Pyroblastouille/Bachelor/readme.md

# Conception d'un plateau de jeu magnétique automatisé
Voir [Rapport/ISC_EMB_resume_diplome_Mariot_Bechevet_2025.pdf](Rapport/ISC_EMB_resume_diplome_Mariot_Bechevet_2025.pdf)
