Pyroblastouille/Bachelor/TB_Controller/1.gif

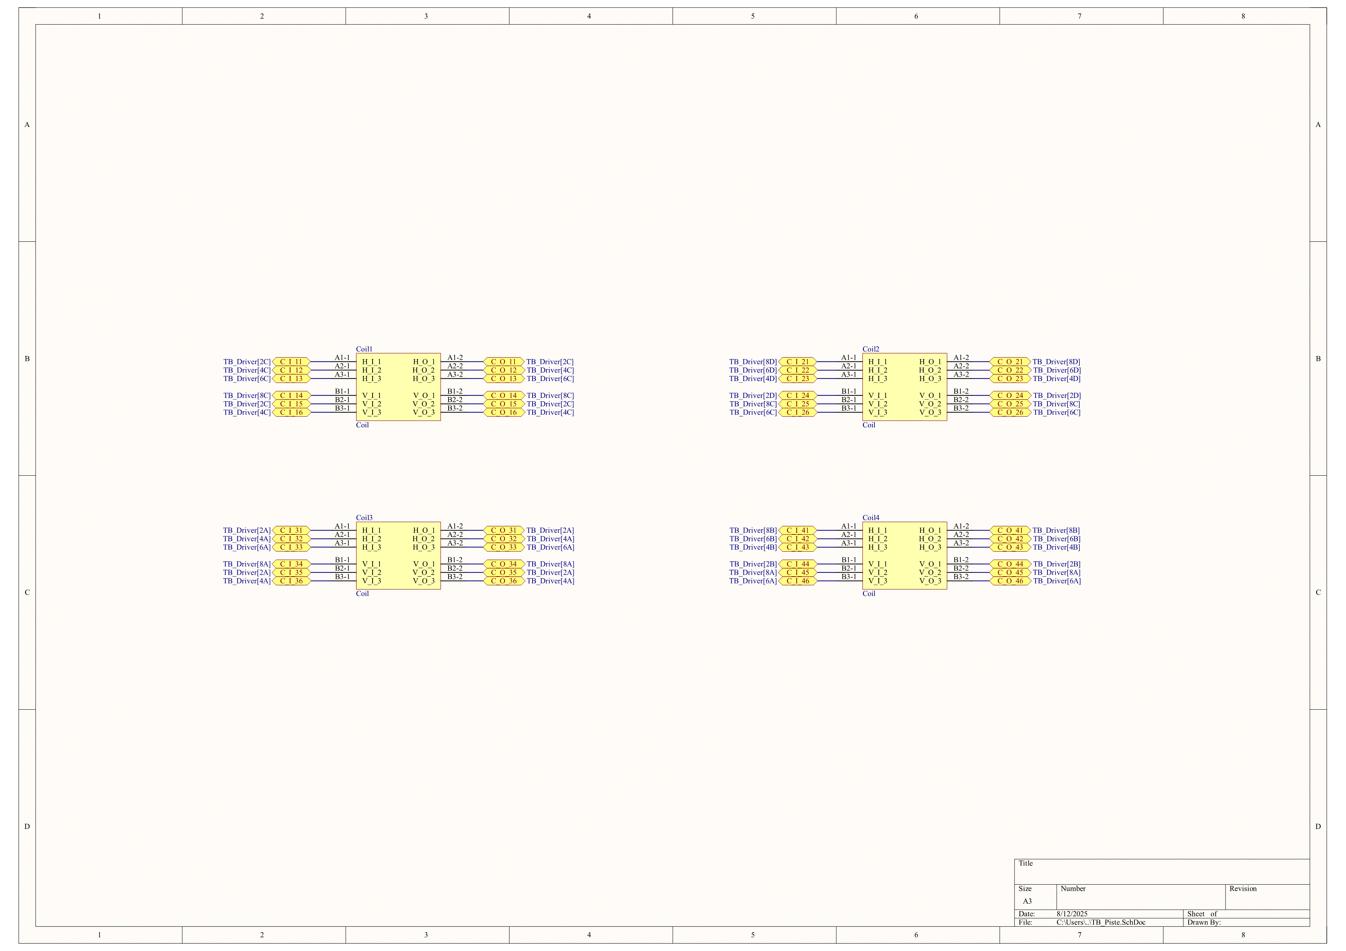
TB_Controller/1.gif
