Pyroblastouille/Bachelor/TB_Controller/2.gif

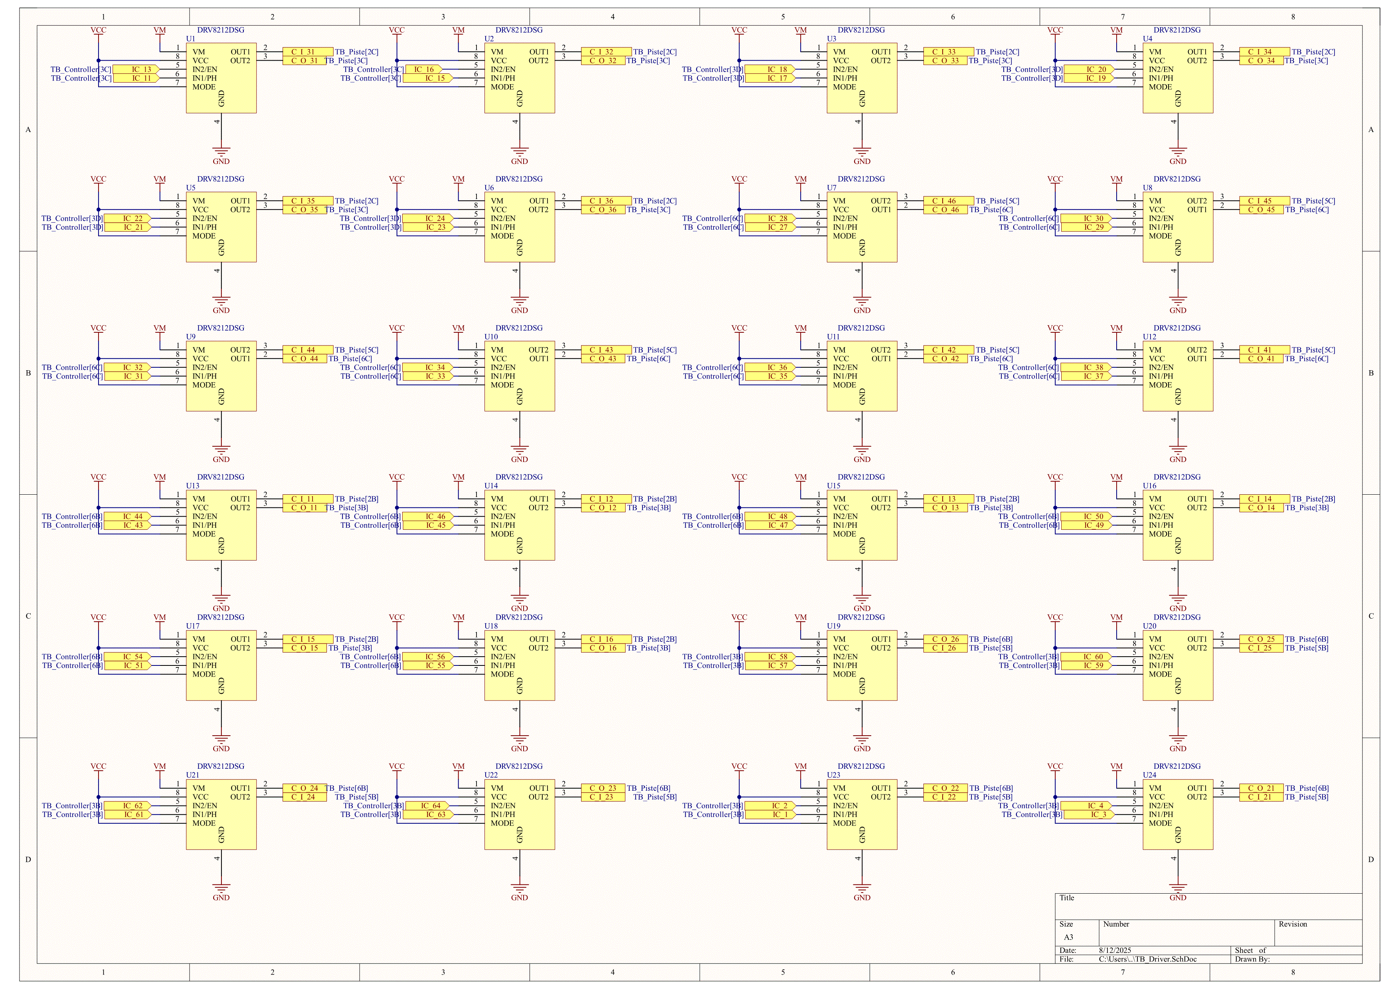
TB_Controller/2.gif
