Pyroblastouille/Bachelor/TB_Controller/3.gif

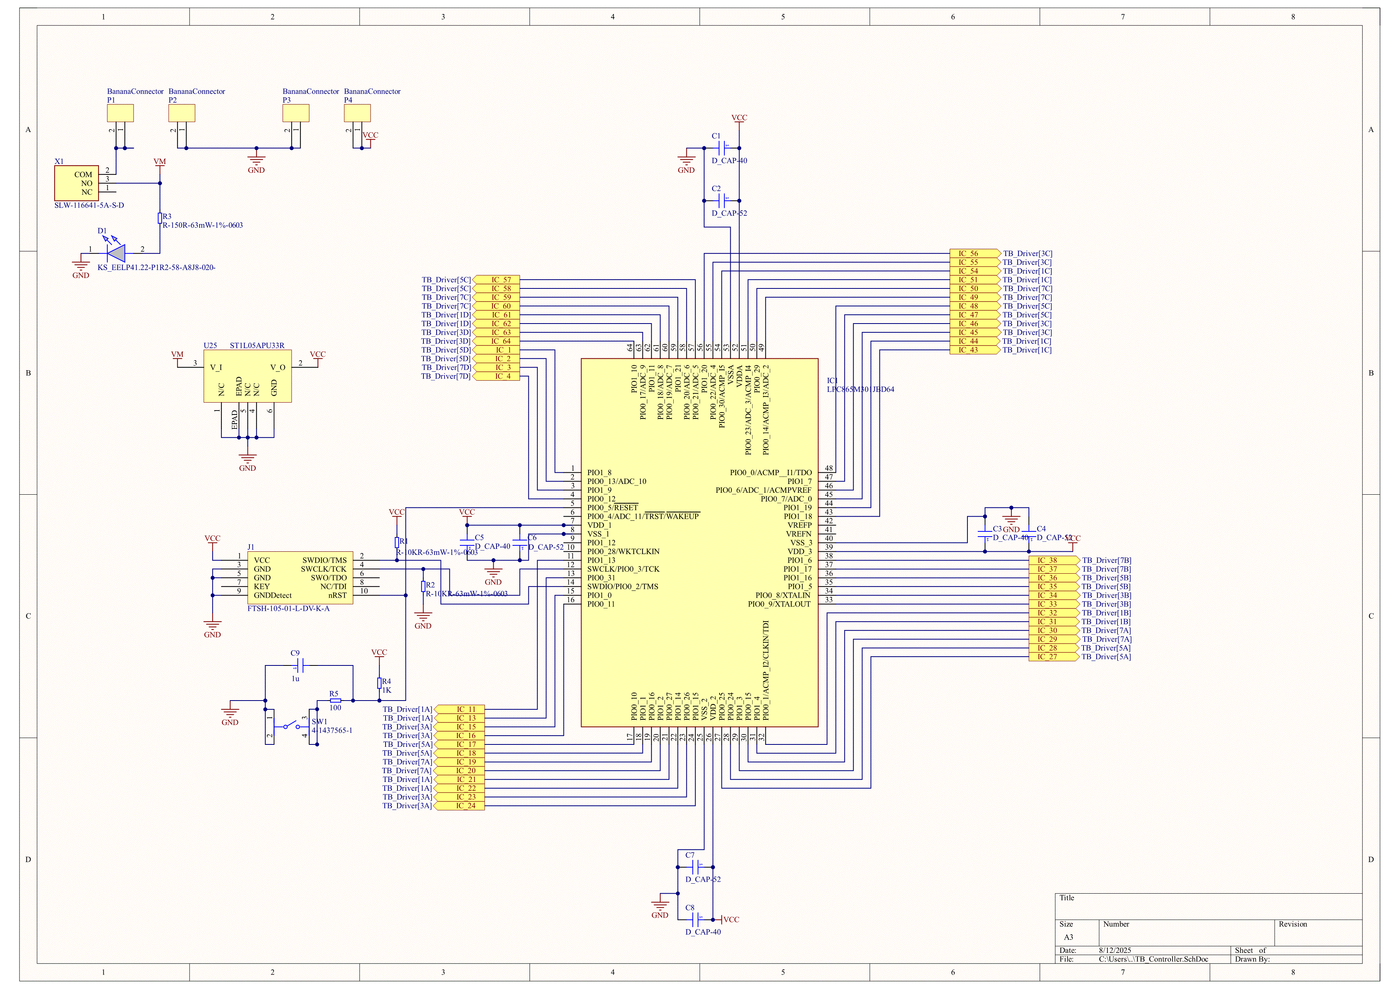
TB_Controller/3.gif
