Pyroblastouille/Bachelor/TB_Controller/4.gif

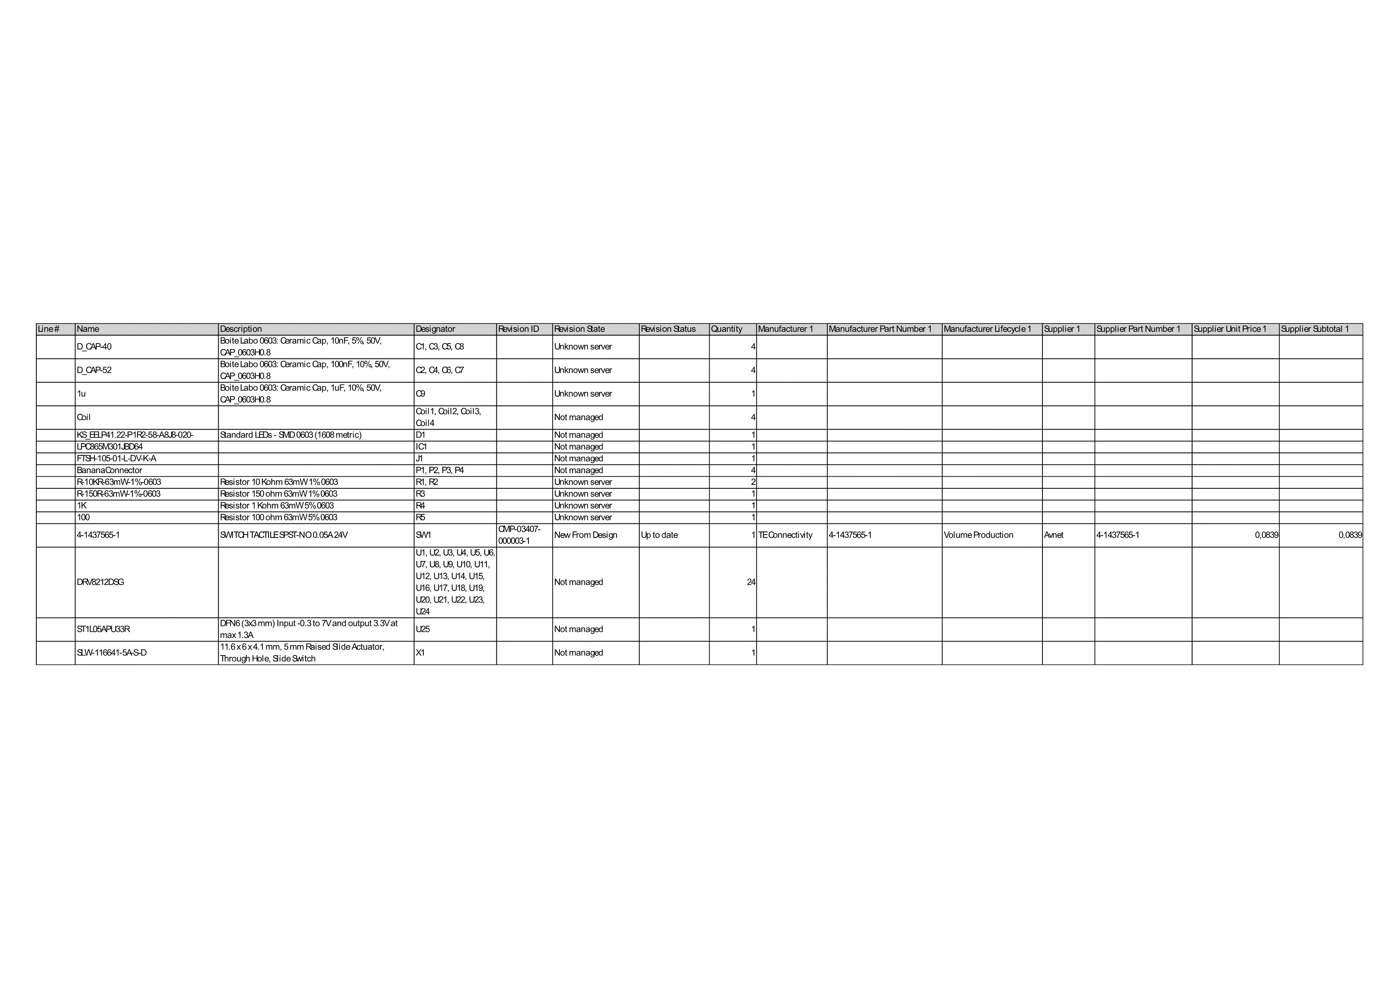
TB_Controller/4.gif
