Pyroblastouille/Bachelor/TB_Controller/TB_Controller-1.png

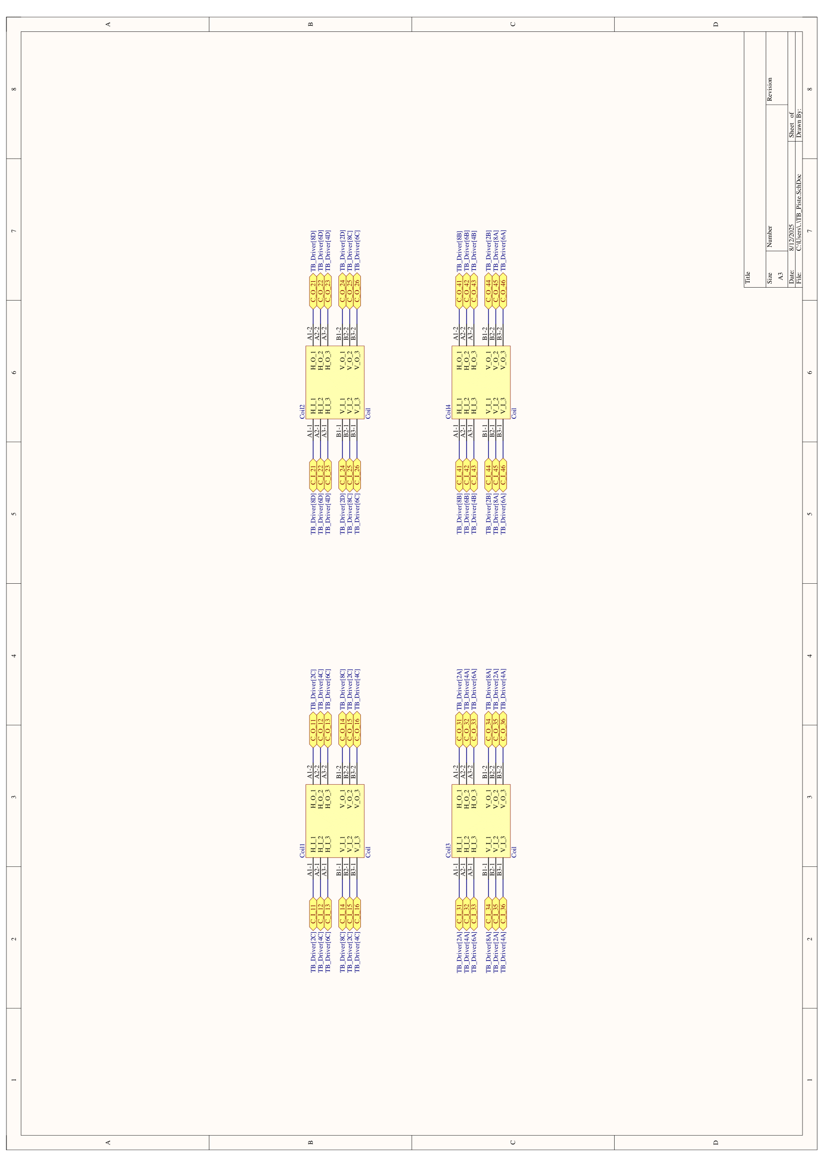
TB_Controller/TB_Controller-1.png
