Pyroblastouille/Bachelor/TB_Controller/TB_Controller-2.png

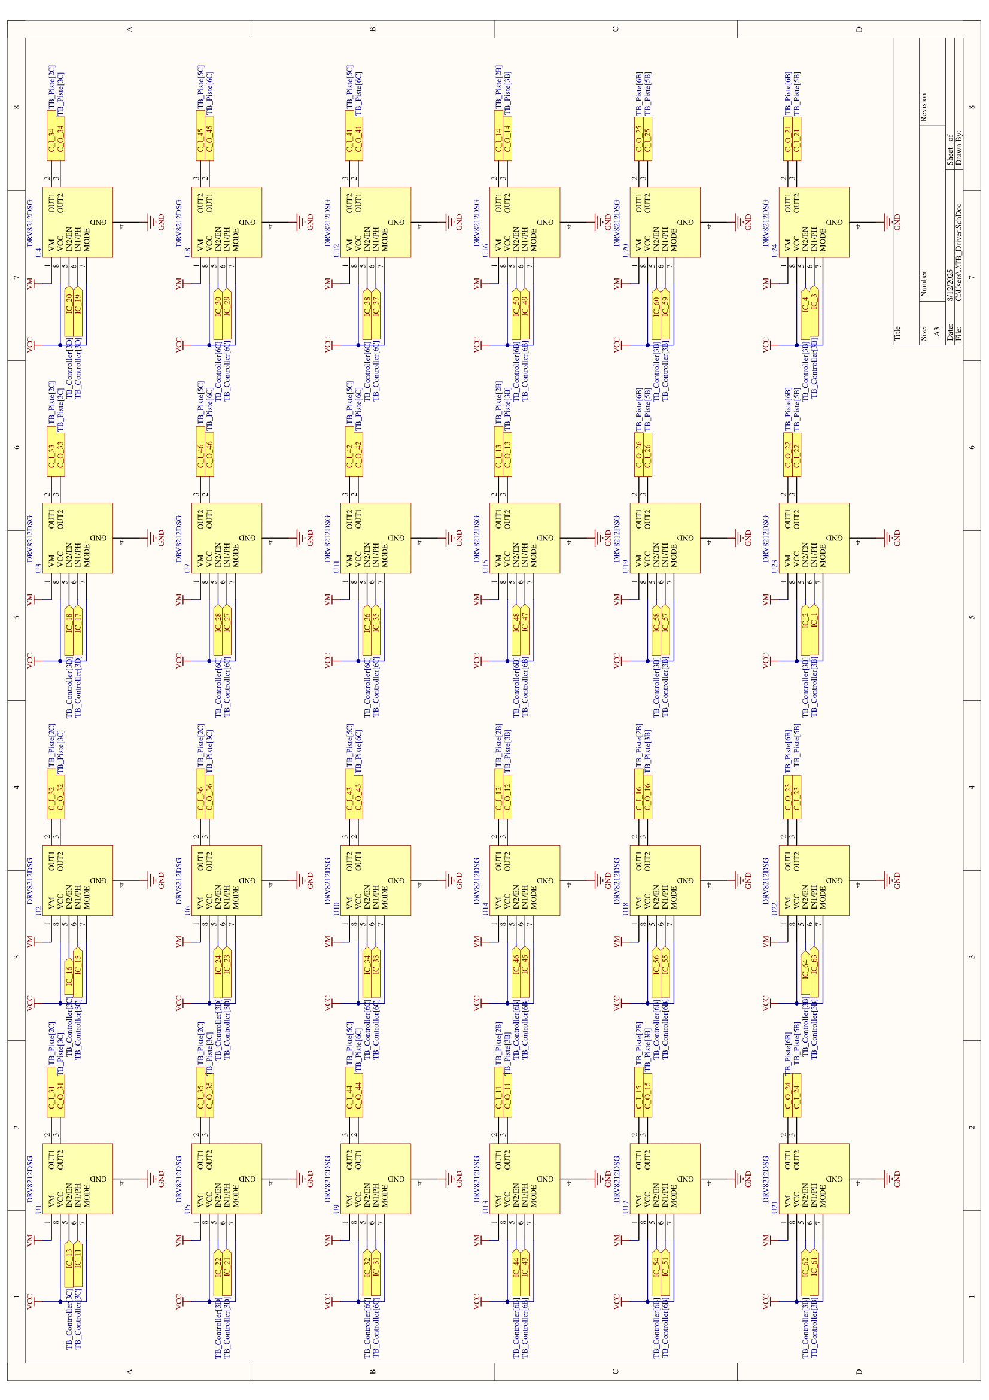
TB_Controller/TB_Controller-2.png
