Pyroblastouille/Bachelor/TB_Controller/TB_Controller-3.png

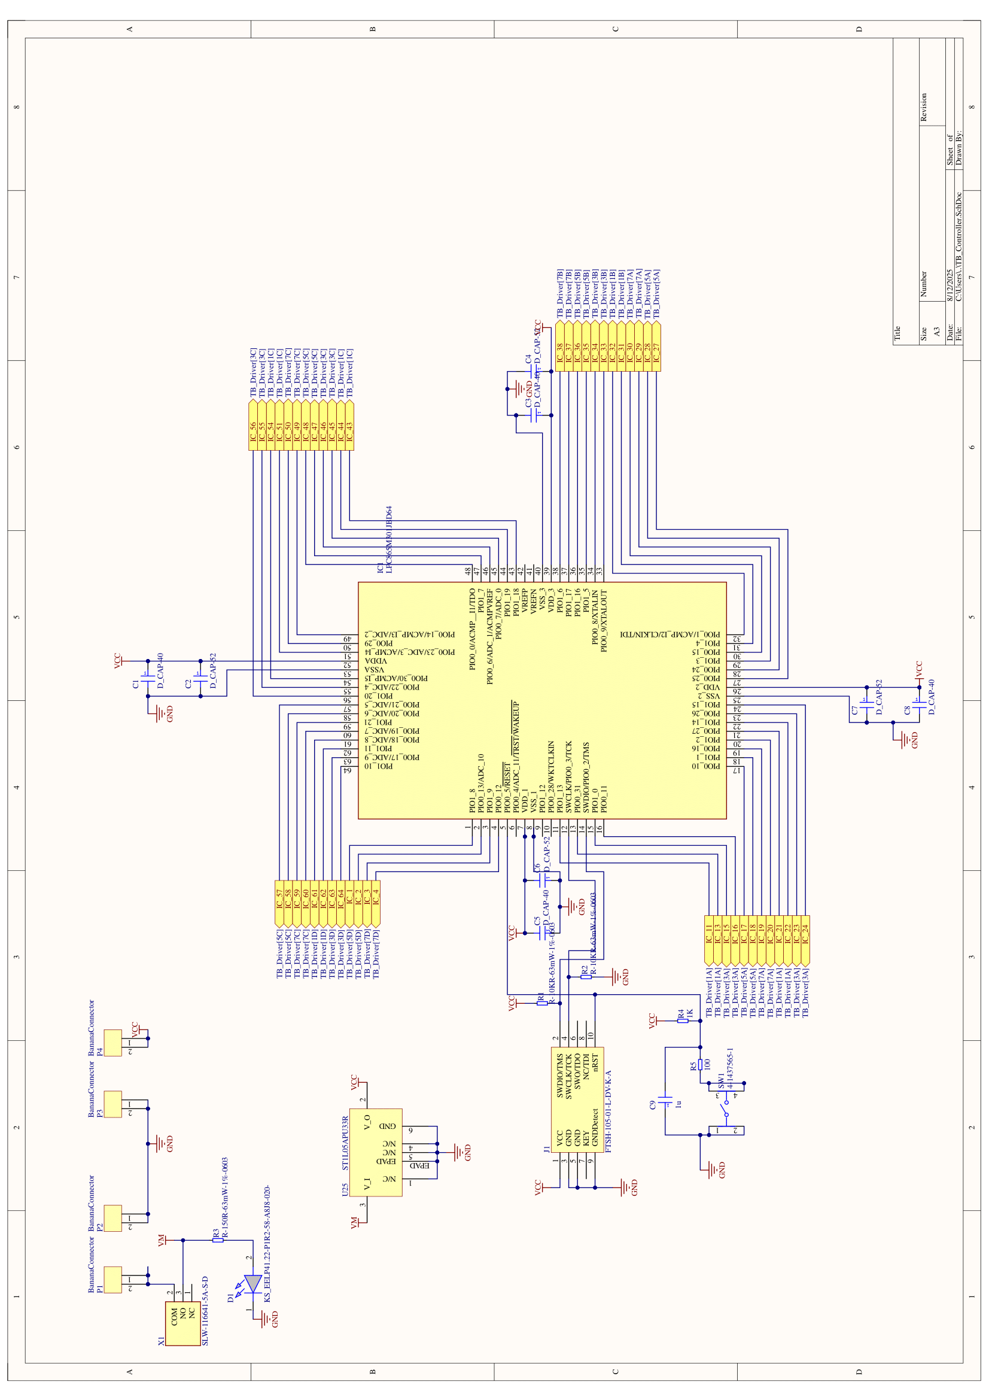
TB_Controller/TB_Controller-3.png
