Pyroblastouille/Bachelor/TB_Controller/TB_Controller-4.png

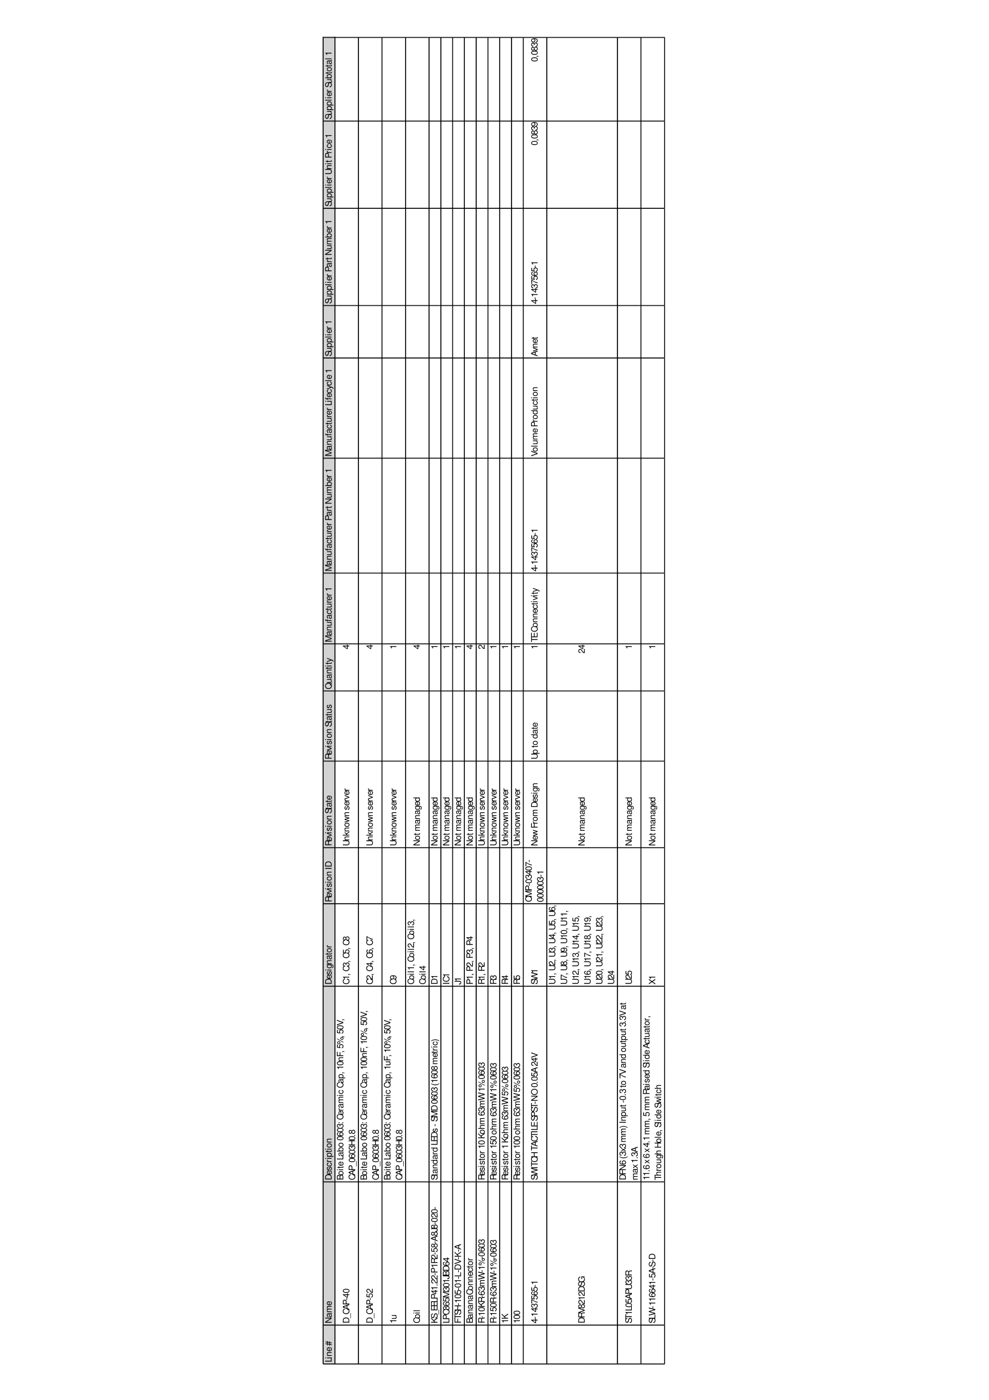
TB_Controller/TB_Controller-4.png
