Pyroblastouille/Bachelor/Prototype 1/Bill of Materials-TB_BOM.xlsx

Name | Description | Designator | Quantity
D_CAP-40 | Boite Labo 0603: Ceramic Cap, 10nF, 5%, 50V, CAP_0603H0.8 | C1, C3, C5, C8 | 4
D_CAP-52 | Boite Labo 0603: Ceramic Cap, 100nF, 10%, 50V, CAP_0603H0.8 | C2, C4, C6, C7 | 4
D_CAP-64 | Boite Labo 0603: Ceramic Cap, 1uF, 10%, 50V, CAP_0603H0.8 | C9 | 1
KS_EELP41.22-P1R2-58-A8J8-020- | Standard LEDs - SMD 0603 (1608 metric) | D1 | 1
LPC865M301JBD64 | Microcontrôleur | IC1 | 1
FTSH-105-01-L-DV-K-A | Connecteur SWD | J1 | 1
BananaConnector | Connecteur Banane | P1, P2, P3, P4 | 4
R-10KR-63mW-1%-0603 | Resistor 10 Kohm 63mW 1% 0603 | R1, R2 | 2
R-150R-63mW-1%-0603 | Resistor 150 ohm 63mW 1% 0603 | R3 | 1
R-1KR-63mW-5%-0603 | Resistor 1 Kohm 63mW 5% 0603 | R4 | 1
R-100R-63mW-5%-0603 | Resistor 100 ohm 63mW 5% 0603 | R5 | 1
4-1437565-1 | SWITCH TACTILE SPST-NO 0.05A 24V | SW1 | 1
DRV8212DSG | Pont en H | U1, U2, U3, U4, U5, U6, U7, U8, U9, U10, U11, U12, U13, U14, U15, U16, U17, U18, U19, U20, U21, U22, U23, U24 | 24
ST1L05APU33R | DFN6 (3x3 mm) Input -0.3 to 7V and output 3.3V at max 1.3A | U25 | 1
SLW-116641-5A-S-D | 11.6 x 6 x 4.1 mm, 5 mm Raised Slide Actuator, Through Hole, Slide Switch | X1 | 1
