Pyroblastouille/Bachelor/TB_Controller.pdf

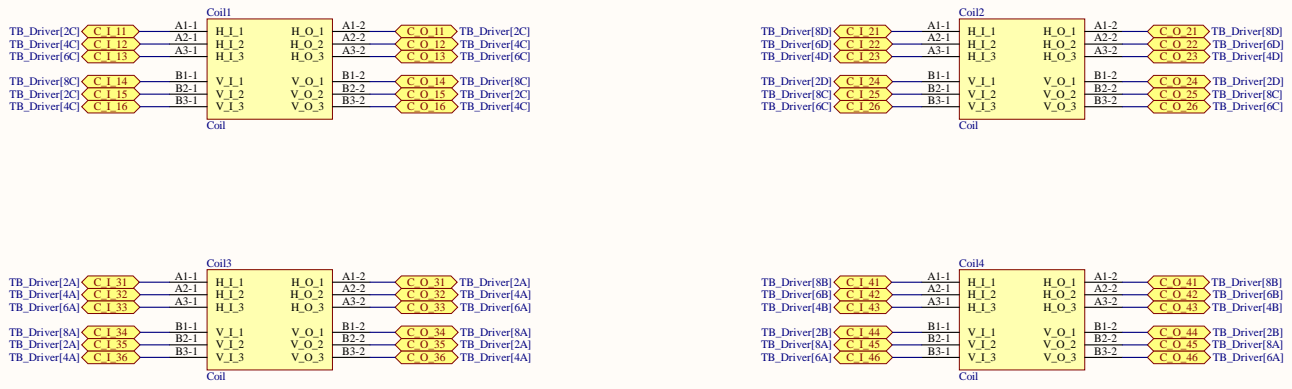
[picture p28: page 1]

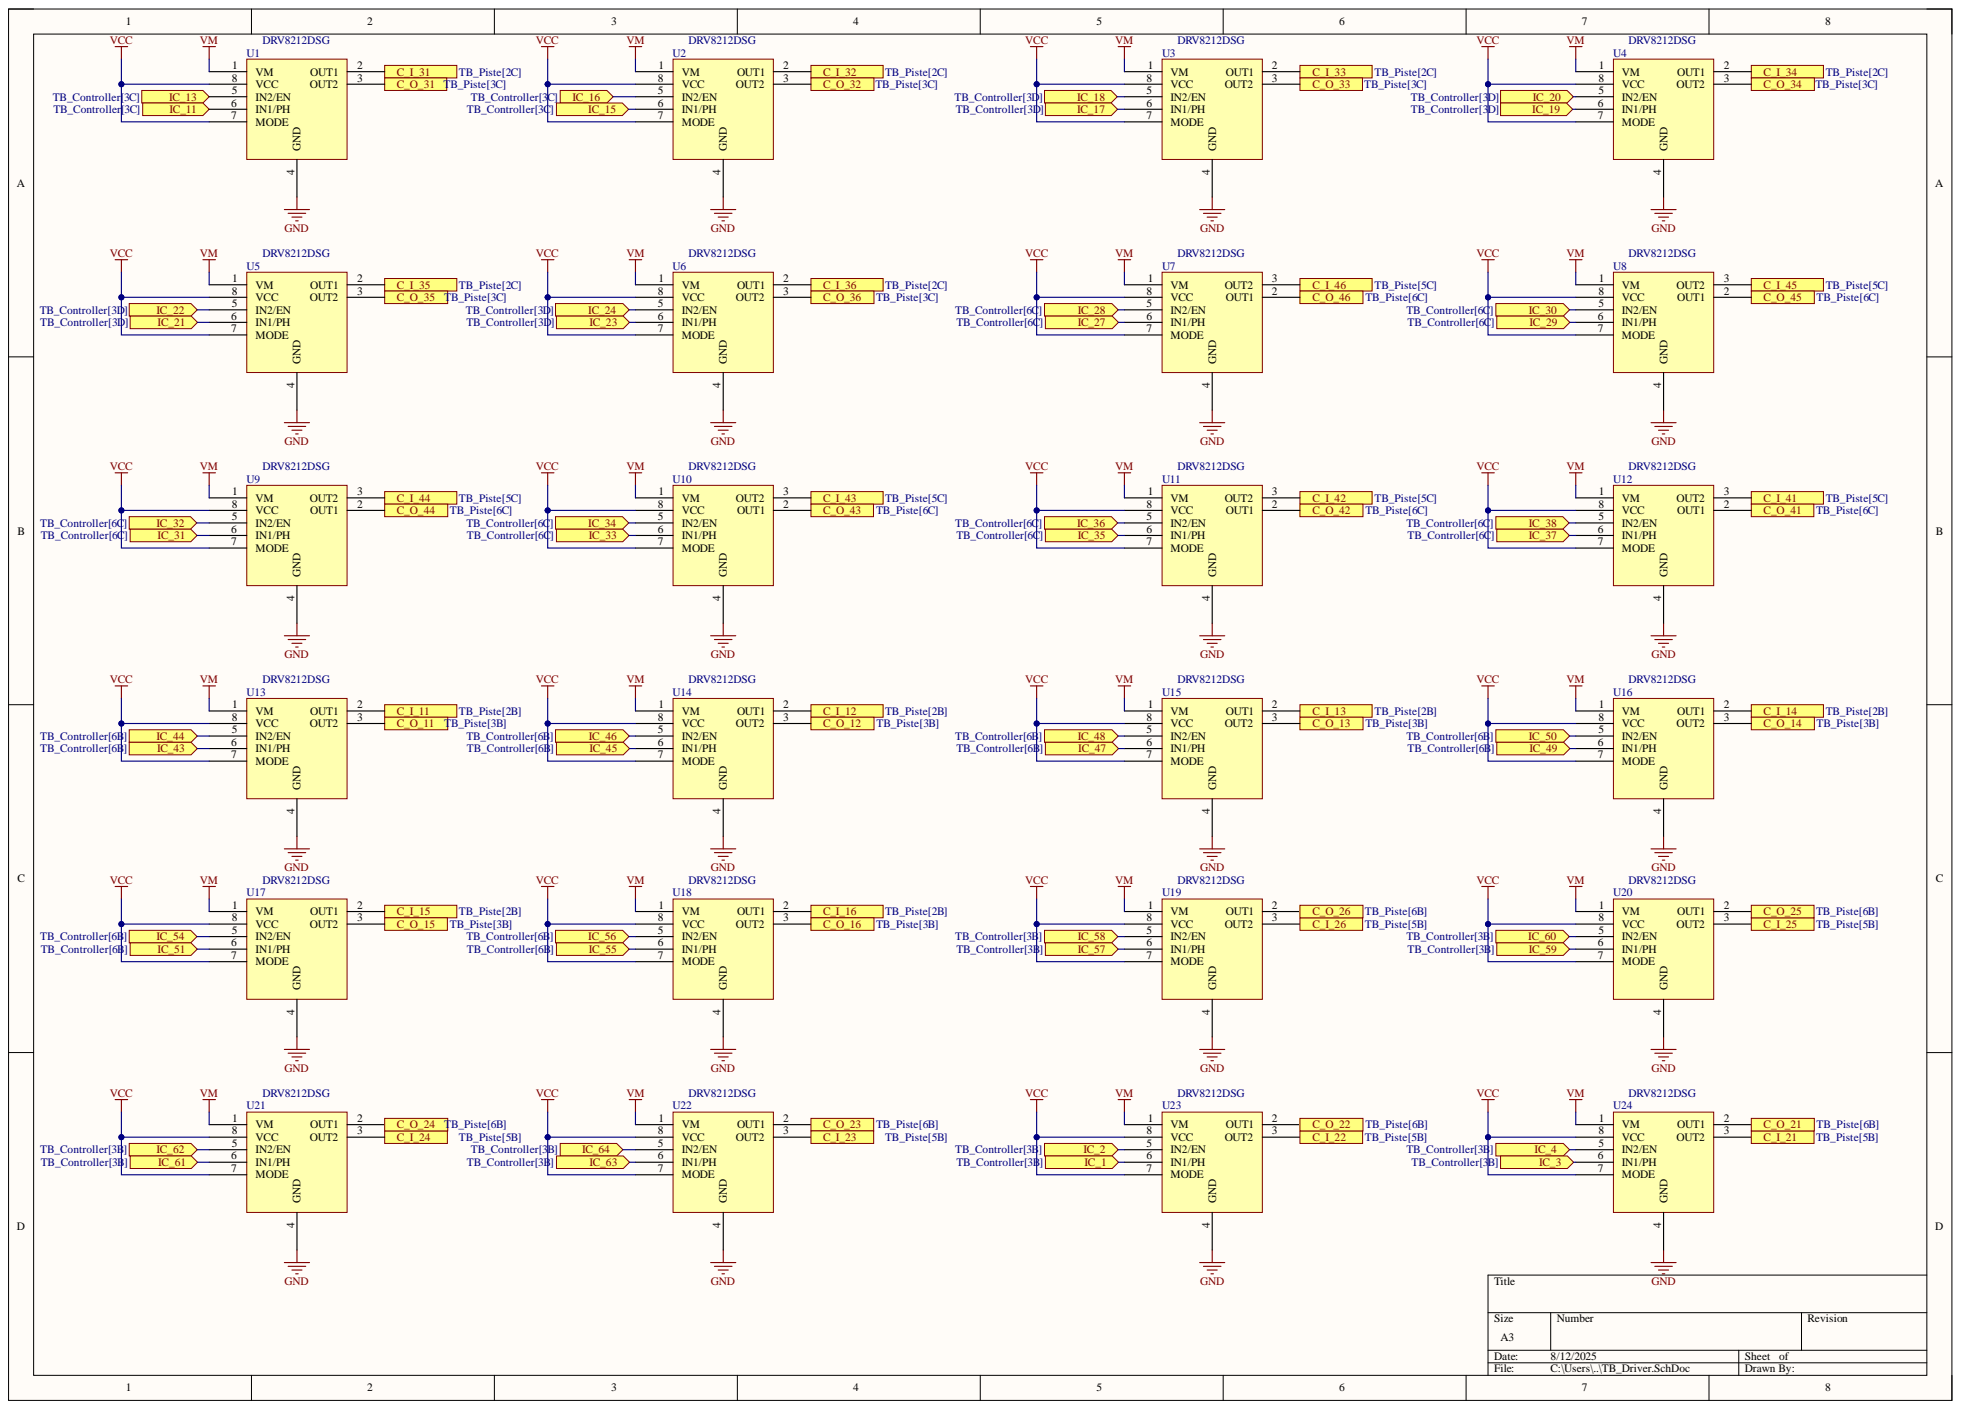
[picture p29: page 2]

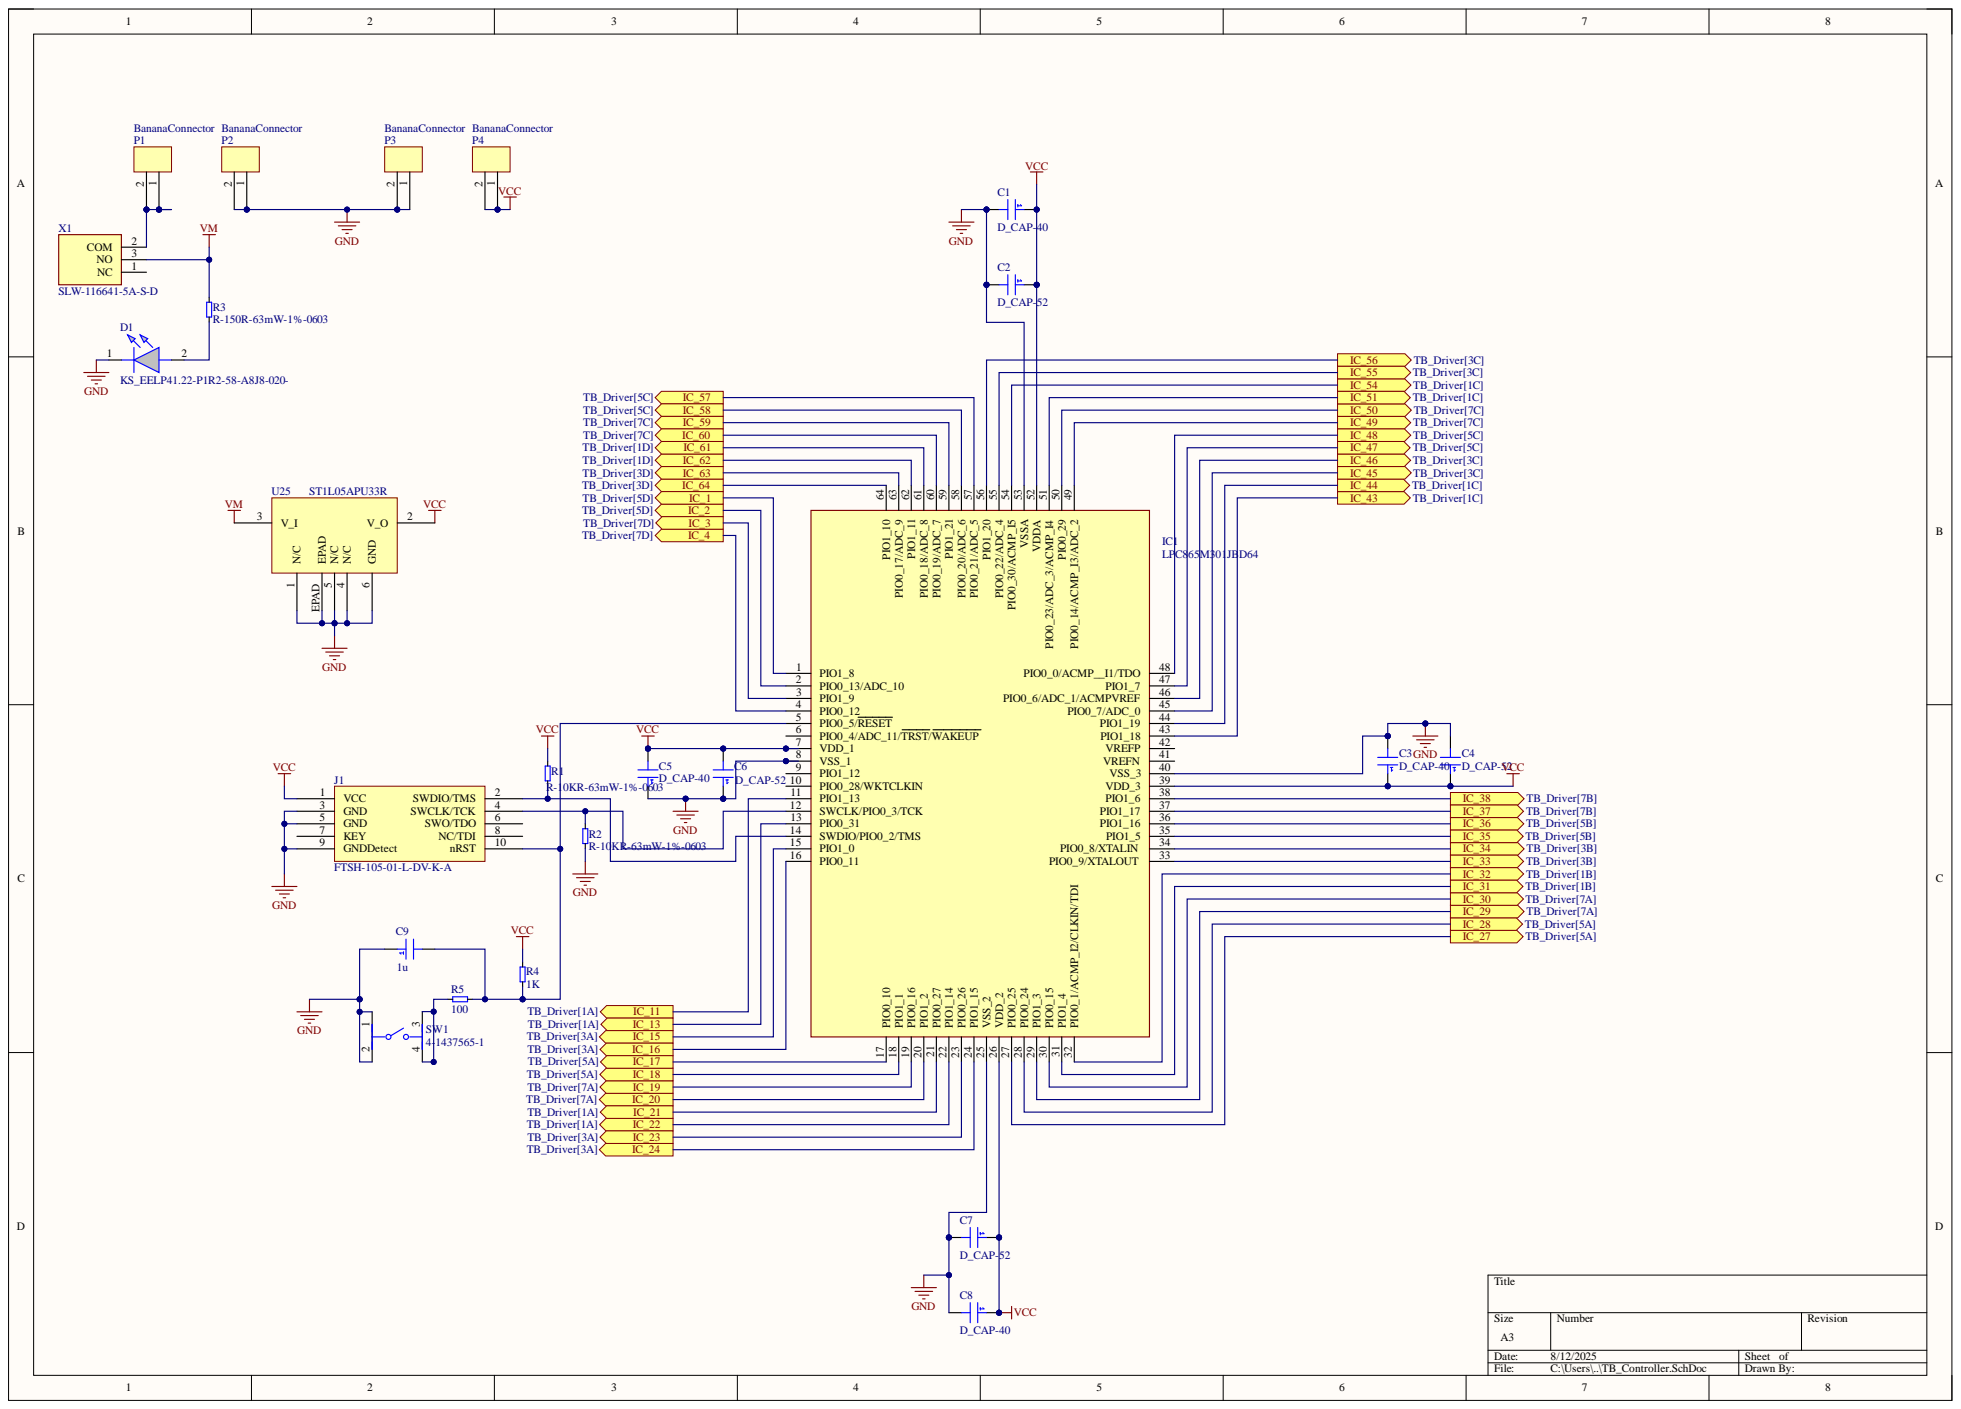
[picture p30: page 3]

Line# | Name | Description | Designator | Revision ID | Revision State | Revision Status | Quantity | Manufacturer 1 | Manufacturer Part Number 1 | Manufacturer Lifecycle1 | Supplier 1 | Supplier Part Number 1 | Supplier Unit Price1 | Supplier Subtotal 1
| D_CAP-40 | BoiteLabo 0603: Ceramic Cap, 10nF, 5%, 50V, CAP_0603H0.8 | C1, C3, C5, C8 | | Unknown server | | 4
| D_CAP-52 | BoiteLabo 0603: Ceramic Cap, 100nF, 10%, 50V, CAP_0603H0.8 | C2, C4, C6, C7 | | Unknown server | | 4
| 1u | BoiteLabo 0603: Ceramic Cap, 1uF, 10%, 50V, CAP_0603H0.8 | C9 | | Unknown server | | 1
| Coil | | Coil1, Coil2, Coil3, Coil4 | | Not managed | | 4
| KS_EELP41.22-P1R2-58-A8J8-020- | Standard LEDs - SMD0603(1608metric) | D1 | | Not managed | | 1
| LPC865M301JBD64 | | IC1 | | Not managed | | 1
| FTSH-105-01-L-DV-K-A | | J1 | | Not managed | | 1
| BananaConnector | | P1, P2, P3, P4 | | Not managed | | 4
| R-10KR-63mW-1%-0603 | Resistor 10Kohm 63mW1%0603 | R1, R2 | | Unknown server | | 2
| R-150R-63mW-1%-0603 | Resistor 150ohm 63mW1%0603 | R3 | | Unknown server | | 1
| 1K | Resistor 1Kohm 63mW5%0603 | R4 | | Unknown server | | 1
| 100 | Resistor 100ohm 63mW5%0603 | R5 | | Unknown server | | 1
| 4-1437565-1 | SWITCHTACTILESPST-NO0.05A24V | SW1 | CMP-03407-000003-1 | New From Design | Up to date | 1 TEConnectivity | | 4-1437565-1 | VolumeProduction | Avnet | 4-1437565-1 | 0,0839 | 0,0839
| DRV8212DSG | | U1, U2, U3, U4, U5, U6, U7, U8, U9, U10, U11, U12, U13, U14, U15, U16, U17, U18, U19, U20, U21, U22, U23, U24 | | Not managed | | 24
| ST1L05APU33R | DFN6(3x3mm) Input -0.3to 7Vand output 3.3Vat max1.3A | U25 | | Not managed | | 1
| SLW-116641-5A-S-D | 11.6x6x4.1mm, 5mm Raised SlideActuator, Through Hole, SlideSwitch | X1 | | Not managed | | 1
