Pyroblastouille/Bachelor/(list of files, drawings)

Other design files:
Prototype 1/proto_1_tb/TB_Components.PcbLib
Prototype 1/proto_1_tb/TB_Components.SchLib
Prototype 1/proto_1_tb/TB_Controller.PrjPcb
Prototype 1/proto_1_tb/TB_Controller.SchDoc
Prototype 1/proto_1_tb/TB_Driver.SchDoc
Prototype 1/proto_1_tb/TB_Piste.SchDoc
