Pyroblastouille/Bachelor/(commit log)

2025-06-25 Added work progress (Without images)
    [Retroplanning.xlsx, proto_1_tb.kicad_pcb, proto_1_tb.kicad_sch]
2025-08-11 Stage changes for work on desktop
    [Bill of Materials-TB_BOM.xlsx, Pin Correspondance.xlsx]
2025-08-11 Added magnet simu (alternate simu to come)
2025-08-12 Added Schematics
2025-08-15 First version of report
    [Bill of Materials-TB_BOM.xlsx]
2025-08-18 Rename/Delete things + made poster and diapo
    [Planning.xlsx, Retroplanning.xlsx]
2025-09-02 Added files that i thought i included
    [TB_Components.PcbLib, TB_Components.SchLib, TB_Controller.PrjPcb, TB_Controller.SchDoc, TB_Driver.SchDoc, TB_Piste.SchDoc, proto_1_tb.kicad_pcb, proto_1_tb.kicad_sch]
